Victor-Aranda-Lopez/WeatherStation_BluePill/Images/back of the sensor.jpg

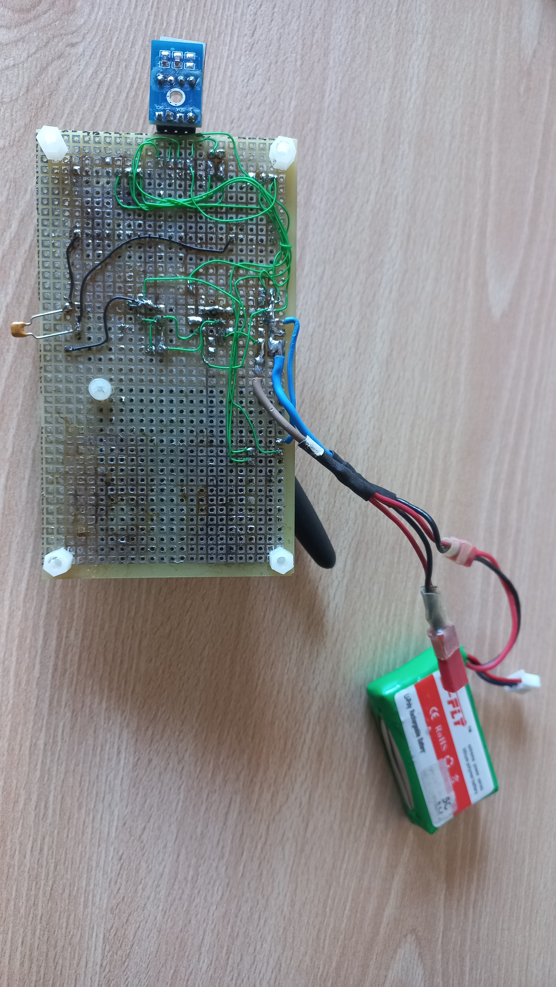
Images/back of the sensor.jpg
