Victor-Aranda-Lopez/WeatherStation_BluePill/Images/microcontroller.jpg

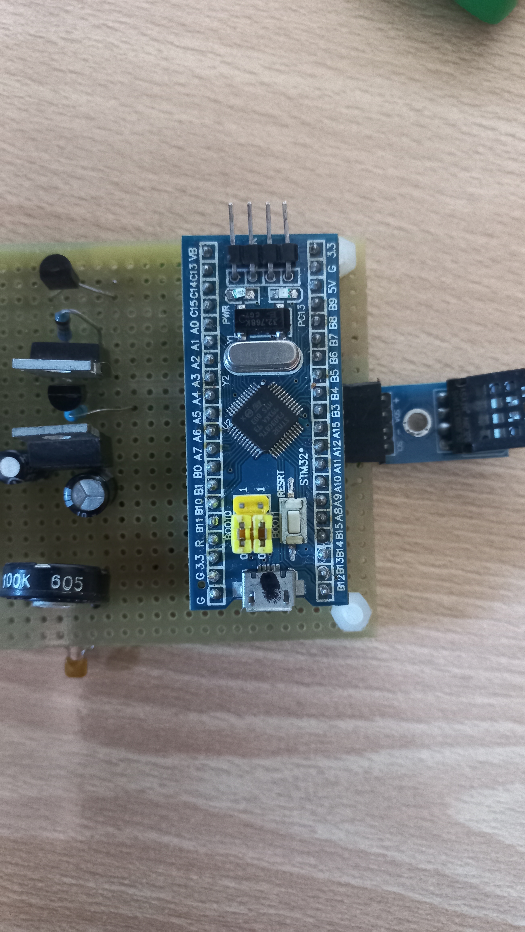
Images/microcontroller.jpg
