Victor-Aranda-Lopez/WeatherStation_BluePill/Schemas/schema simple.pdf

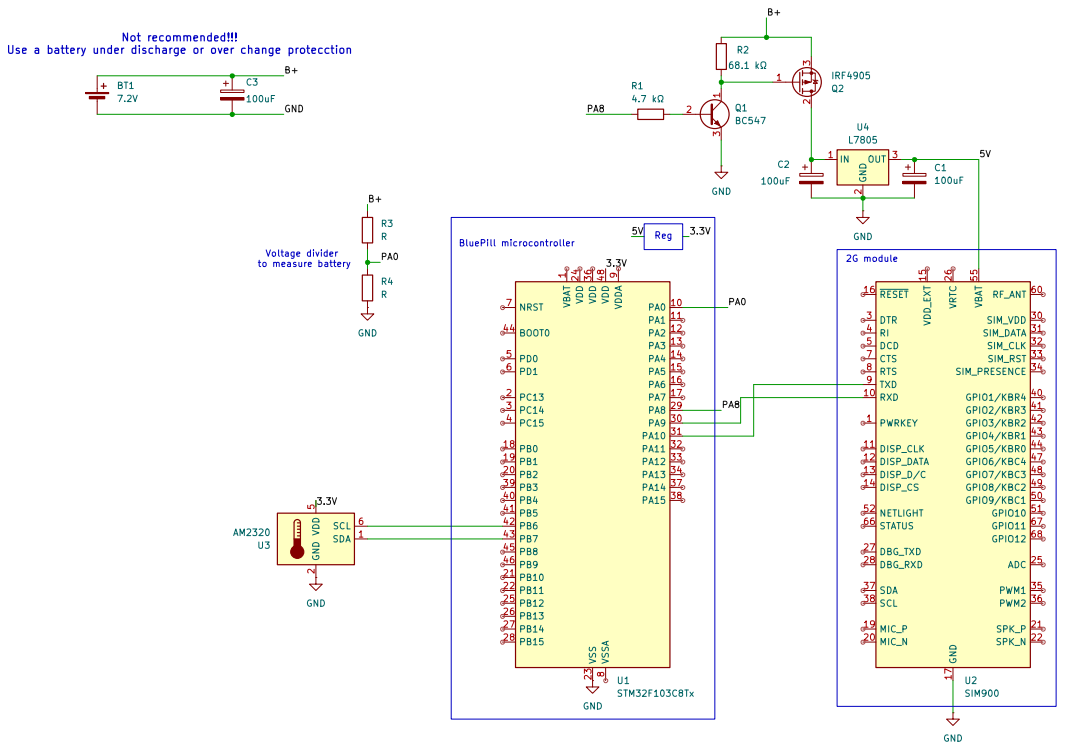
[picture p5: page 1]
