Victor-Aranda-Lopez/WeatherStation_BluePill/Schemas/schema with solar charger module.pdf

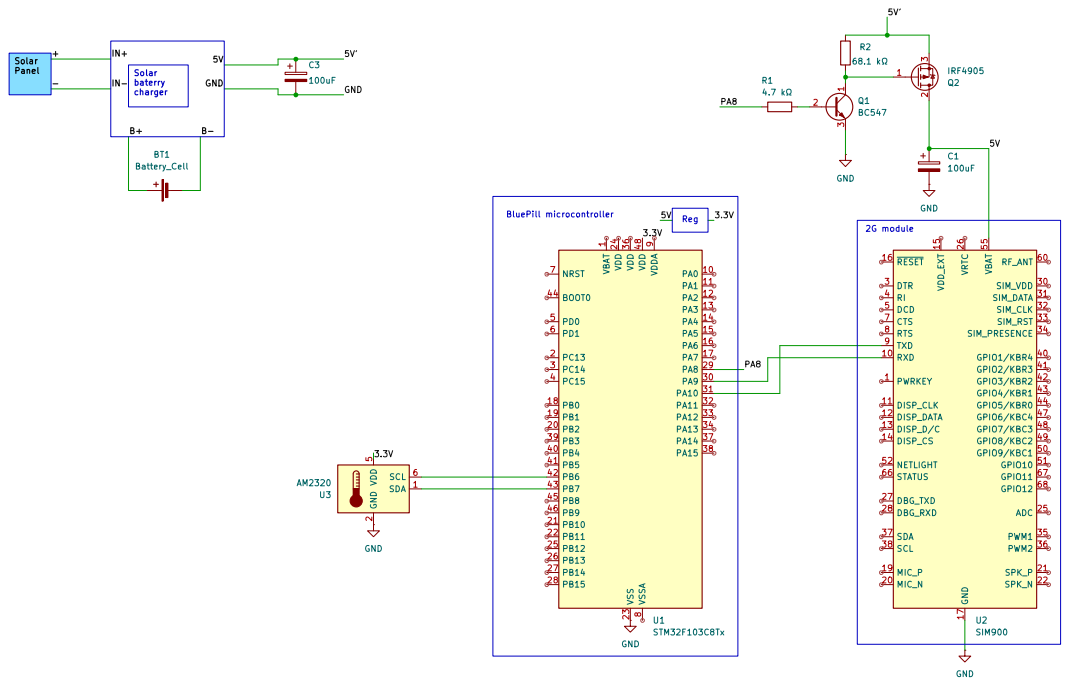
[picture p6: page 1]
