Victor-Aranda-Lopez/WeatherStation_BluePill/Microcontroller_Code/Core/Src/main.cpp

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
/* Includes ------------------------------------------------------------------*/
#include "main.h"

/* USER CODE BEGIN Includes */
#include <sim900a.h>
#include <utilfunctions.h>
#include <time.h>
#include "stm32f1xx.h"
#include <am2320.h>
#include <battery_reader.h>
#define MAX_MEASURE_RETRIES 5
#define MAX_MQTT_PUBLISH_RETRIES 3
#define AM2320_I2C_ADDR = 0x5C<<1;
using namespace std;
Measure measures;
SIM900A sim900a;
BatteryReader bateryReader;

/* USER CODE END Includes */

I2C_HandleTypeDef hi2c1;
ADC_HandleTypeDef hadc1;
RTC_HandleTypeDef hrtc;

UART_HandleTypeDef huart1;
UART_HandleTypeDef huart2;

void SystemClock_Config(void);
static void MX_GPIO_Init(void);
static void MX_USART2_UART_Init(void);
static void MX_I2C1_Init(void);
static void MX_USART1_UART_Init(void);
static void MX_RTC_Init(void);
static void MX_ADC1_Init(void);
/**
  * @brief  The application entry point.
  * @retval int
  */
int main(void)
{
  /* MCU Configuration--------------------------------------------------------*/

  /* Reset of all peripherals, Initializes the Flash interface and the Systick. */
  HAL_Init();

  /* Configure the system clock */
  SystemClock_Config();
  HAL_ResumeTick();
  /* Initialize all configured peripherals */
  MX_GPIO_Init();
  MX_USART2_UART_Init();
  MX_I2C1_Init();
  MX_USART1_UART_Init();
  MX_RTC_Init();
  MX_ADC1_Init();
  /* USER CODE BEGIN 2 */
  //Init
   if (__HAL_PWR_GET_FLAG(PWR_FLAG_SB) != RESET)
   {
	   __HAL_PWR_CLEAR_FLAG(PWR_FLAG_SB);
	   __HAL_PWR_CLEAR_FLAG(PWR_FLAG_WU);
   }
   HAL_PWR_EnableBkUpAccess();

   enablePeripherals();
   HAL_Delay(1000);

   Am2320_HandleTypeDef Am2320_;
   bateryReader.initBatteryLevel(hadc1);
   Am2320_ = am2320_Init(&hi2c1,AM2320_ADDRESS);
   measures.humidity = -1;
   measures.temperature = -300;
   //Make measurement
   int measurementTries = 0;
	do {
		if(measurementTries) {// Wait if it is a retry
			HAL_Delay(1000);
		}
		float temperature, humidity;
		am2320_GetTemperatureAndHumidity(&Am2320_, &temperature, &humidity);
		measures.humidity = humidity;
		measures.temperature = temperature;
		measures.battery = bateryReader.getBatteryLevel();//45 por ajuste de error (con condensador). Sin condensador son 30
		measurementTries++;
		//If measure is wrong, then retry up to MAX_MEASURE_RETRIES
	} while((measures.humidity == 0 || measures.temperature == 0) && measurementTries < MAX_MEASURE_RETRIES);

	//Config GSM
   if(sim900a.init()){
	   // GSM started
	   int publish_Tries = 0;
	   //Send measurement to server
	   while(!sendMeasuresToServer(measures) && publish_Tries < MAX_MQTT_PUBLISH_RETRIES){
		   HAL_Delay(3000);
		   publish_Tries++;
	   }
   }

   //Disconnect and finish
   sim900a.shutdown();

   disablePeripherals();

   sleepForNextMeasure();
   /* USER CODE END 2 */

   /* Infinite loop */
   /* USER CODE BEGIN WHILE */
   while (1)
   {
   /* USER CODE END WHILE */

   /* USER CODE BEGIN 3 */
   }
  /* USER CODE END 3 */
}

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
