Victor-Aranda-Lopez/WeatherStation_BluePill/(notices)

Notices in the files:
Microcontroller_Code/Core/Src/main.cpp:
Copyright (c) 2023 STMicroelectronics.
All rights reserved.
This software is licensed under terms that can be found in the LICENSE file
