Victor-Aranda-Lopez/WeatherStation_BluePill/Images/microcontroller with battery.jpg

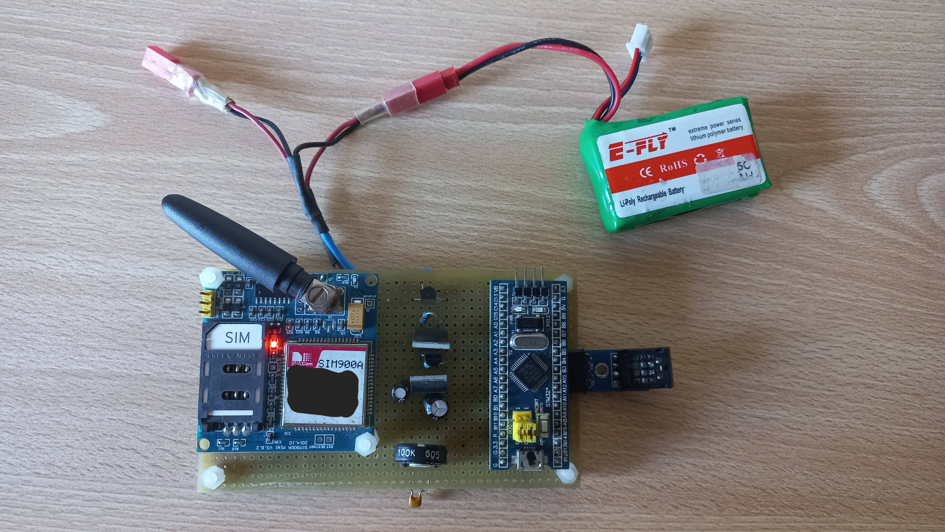
[picture p1: Images/microcontroller with battery.jpg]
Images/microcontroller with battery.jpg
